trinler007/HA-Compass/dashboard/README.md

# Dashboard (Ziel 2)

## Fahrzeuggrafik

| Datei | Verwendung |
| --- | --- |
| `assets/nx01-top.svg` | Vektor-Draufsicht, Front oben, Maßstab 1 px = 10 mm, Drehpunkt (122.5, 349.5) – für Lovelace (Smartphone, Tablet, PC) |
| `assets/nx01-top-{120,180,240,360}.png` | transparente PNG-Exporte in fester Höhe – für openHASP (`img`-Objekt, Drehung über `angle`) |
| `assets/nx01-side.svg` | Seitenansicht (Fahrerseite, Front links), 1 Einheit = 10 mm, Bodenlinie unten – für Nicken |
| `assets/nx01-rear.svg` | Heckansicht, 1 Einheit = 10 mm, Bodenlinie unten – für Rollen |
| `assets/nx01-side-{400,800}.png`, `assets/nx01-rear-{240,480}.png` | transparente PNG-Exporte (z. B. für die Ultra Vehicle Card) |
| `../openhasp/nx01-side-289x150.png`, `../openhasp/nx01-rear-129x150.png` | passend für die Bildfelder der Nivellierseite (Seite 2) |

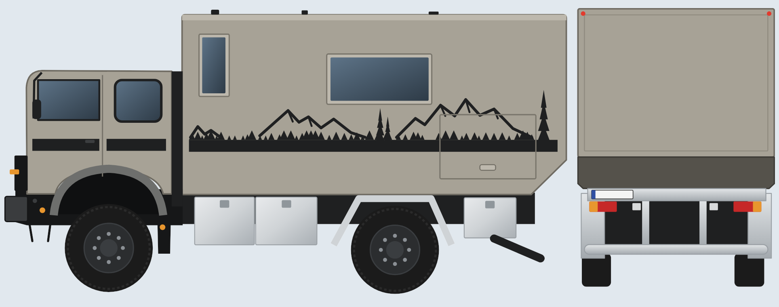
[picture p1: dashboard/ansichten-vorschau.png]
Seiten- und Heckansicht


Kennzeichen, Firmenlogos und Motive Dritter sind bewusst nicht enthalten; das Dekor ist vereinfacht nachgezeichnet.

Nachgezeichnet nach Drohnenaufnahmen (Tunesien), der Dachkamera und den Fahrzeugmaßen (6990 × 2450 mm):

- Fahrerhaus mit mittiger Dachprofilierung (Sicken)
- Wohnkoffer mit 6 Solarmodulen (2 × 3) und Dachfenster
- rechts in einer Flucht, von vorn nach hinten: 5G-Antenne (weiß), WiFi-Antenne (weiß), Kathrein HDZ 100 Kabel-Dachdurchführung
- Heck rechts: LoRa-Magnetfußantenne auf weißem Blech 35 × 35 cm, links daneben Starlink Mini

## Konzept

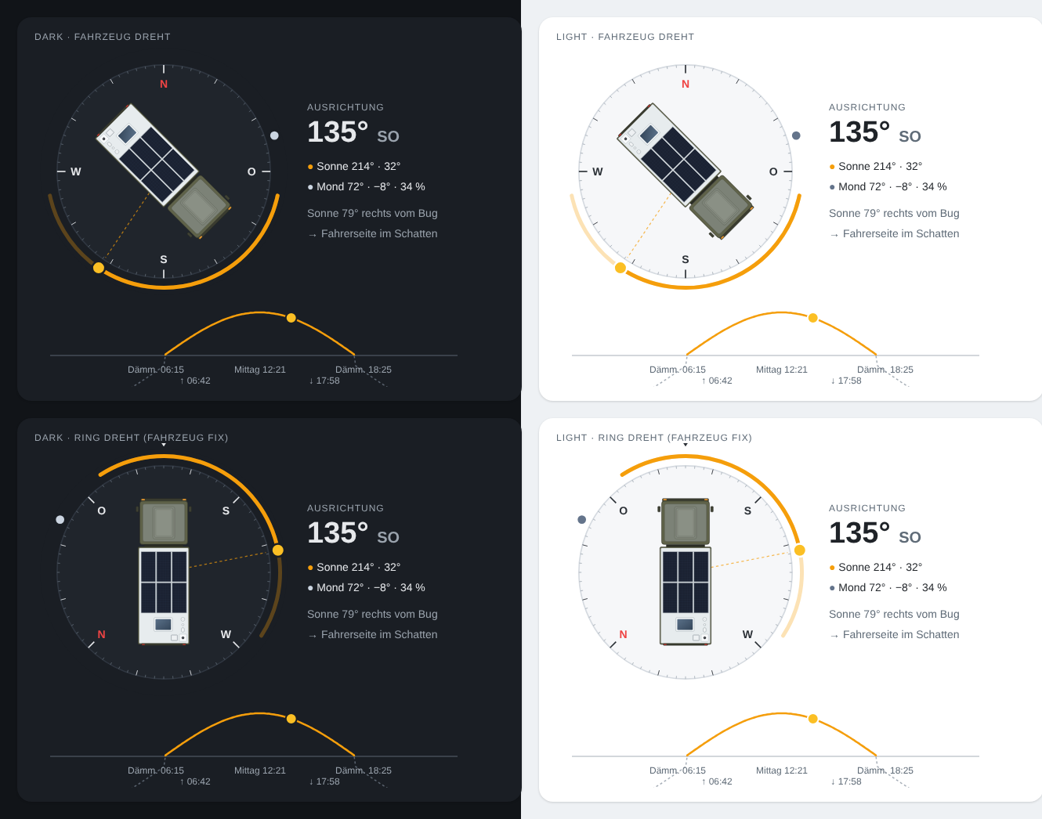
[picture p2: dashboard/konzept.png]
Konzept


- Kompassring mit Himmelsrichtungen; konfigurierbar: **Fahrzeug dreht** (Nord oben) oder **Ring dreht** (Fahrzeug fix, Fahrtrichtung oben)
- helles und dunkles Design (folgt dem HA-Theme)
- Horizontstreifen mit Sonnenhöhe über den Tag, Dämmerung, Auf-/Untergang, Mittag (ersetzt die Horizon Card)
- Sonnenbahn des Tages (Aufgang → Untergang) mit aktueller Sonnenposition
- Mondposition und -phase
- Text: Ausrichtung, Sonnen-/Mondstand, Sonne relativ zum Fahrzeug („Fahrerseite im Schatten“)

Die Mockup-Werte sind Beispielwerte.

## Architektur

```
HA-Compass (HACS-Integration, Domain ha_compass)
├── Sensoren für die aktuelle GPS-Position (nicht die HA-Heimatposition):
│   Sonne: Azimut, Höhe, Dämmerung, Aufgang, Mittag, Untergang
│   Mond:  Azimut, Höhe, Phase, Beleuchtung, Auf-/Untergang
│   relativ zum Fahrzeug: Sonnenwinkel zum Bug, beschattete Seite
├── Lovelace-Karte ha-compass-card (wird von der Integration mitgeliefert und registriert)
└── openHASP-Seite 480 × 480 (Vorlage)
```

Eine eigene Integration ist nötig, weil die HA-Integrationen `sun` und `moon` mit der festen Heimatposition rechnen
und keine Mondposition liefern. Im Wohnmobil muss mit der GPS-Position gerechnet werden.

## Lovelace-Karte `ha-compass-card`

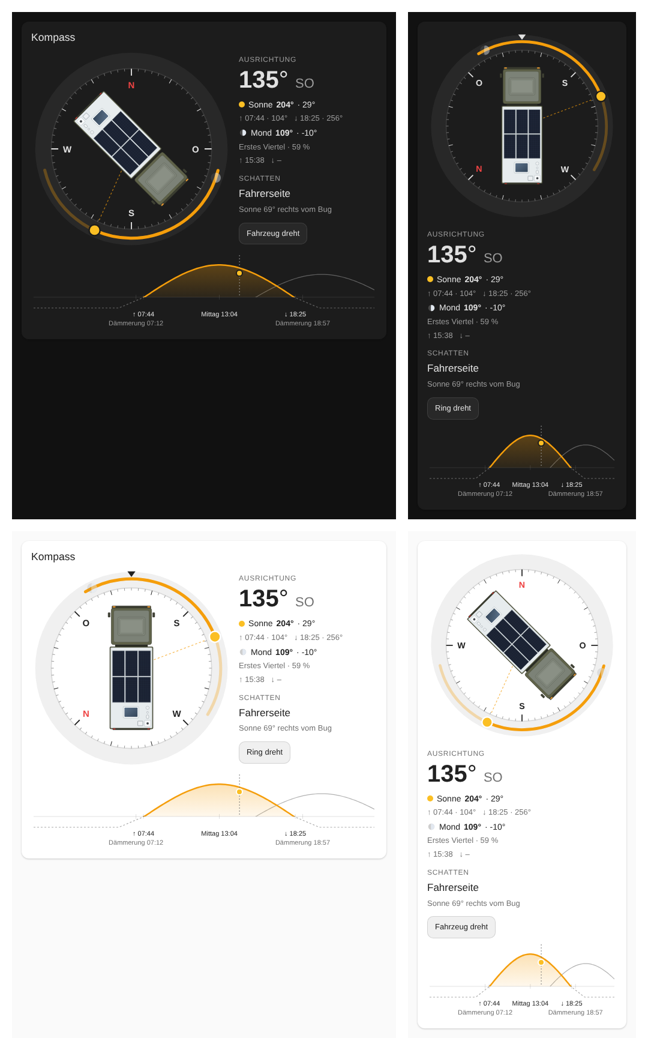
[picture p3: dashboard/karte-vorschau.png]
Vorschau


Die Karte wird von der Integration mitgeliefert und beim Start automatisch als Dashboard-Ressource (`/ha_compass/ha-compass-card.js`, JavaScript-Modul) eingetragen – keine separate HACS-Installation. Bei Dashboards im YAML-Modus die Ressource von Hand eintragen. Nach Updates einmal die Seite ohne Cache neu laden.
Sie folgt dem HA-Theme (hell/dunkel) und ordnet sich ab ca. 520 px Kartenbreite nebeneinander an, darunter untereinander.

```yaml
type: custom:ha-compass-card
heading_entity: sensor.kompass_ausrichtung_geografisch
title: Kompass
```

Alle Elemente lassen sich einzeln ein- und ausblenden (Standard: alles an) – im visuellen Editor in den Abschnitten *Kompass*, *Infospalte* und *Horizontverlauf*:

| Option | Standard | Wirkung |
| --- | --- | --- |
| `view` | `auto` | `auto` = folgt `select.ha_compass_ansicht`, `vehicle` = Fahrzeug dreht, `ring` = Ring dreht |
| `show_compass` | `true` | Kompass komplett |
| `show_vehicle`, `show_ticks`, `show_cardinals` | `true` | Fahrzeug, Skala, Himmelsrichtungen |
| `show_sun`, `show_sun_path`, `show_moon` | `true` | Sonne mit Richtungsstrahl, Sonnenbahn, Mond |
| `show_bow_marker` | `true` | Markierung „vorne“ im Modus *Ring dreht* |
| `tap_action` | `toggle_view` | `toggle_view` oder `none` |
| `compass_size` | – | maximale Kompassgröße in px |
| `vehicle_image` | – | eigenes Fahrzeugbild (URL, Front oben) |
| `show_info` | `true` | Infospalte komplett |
| `show_heading`, `show_sun_info`, `show_moon_info`, `show_shade`, `show_view_button` | `true` | einzelne Blöcke der Infospalte |
| `show_mobile_panel` | `true` | Solartaschen stilisiert in der Kompassrose: empfohlene Richtung (orange Kante = Sonnenseite), Breite nach Neigung |
| `show_solar`, `show_mobile` | `true` | Solarspalte rechts: Dach (tagsüber Ist/erwartet/Performance, nachts Prognose morgen) und Solartaschen-Empfehlung; erscheint nur mit den Solar-Sensoren der Integration |
| `show_horizon`, `show_moon_path` | `true` | Horizontverlauf, Mondkurve darin |

Beispiel – nur der Ring für eine Unterseite:

```yaml
type: custom:ha-compass-card
heading_entity: sensor.kompass_ausrichtung_geografisch
show_info: false
show_horizon: false
```

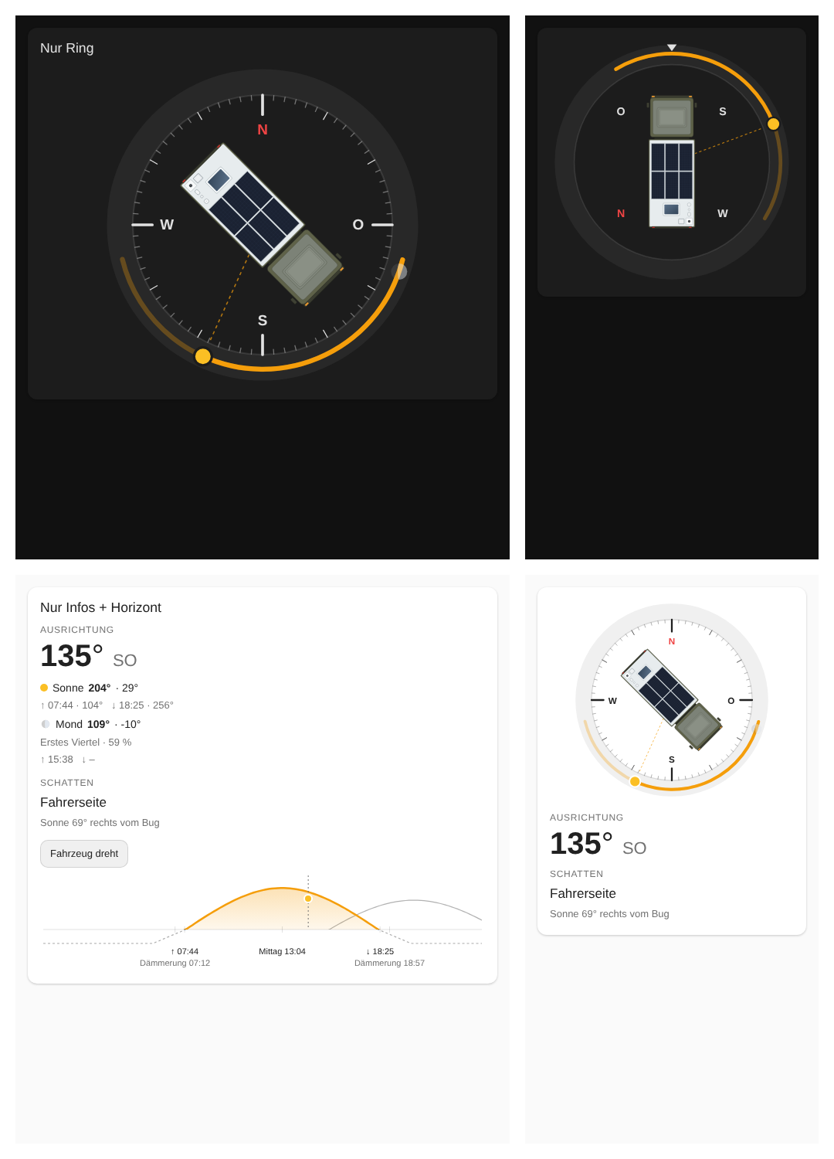
[picture p4: dashboard/karte-varianten.png]
Varianten


Tippen auf den Kompass oder den Button schaltet die Ansicht um (bei `view: auto` für alle Anzeigen inkl. openHASP).
Die Karte ist auch im visuellen Editor konfigurierbar.

## Nivellier-Karte `ha-level-card`

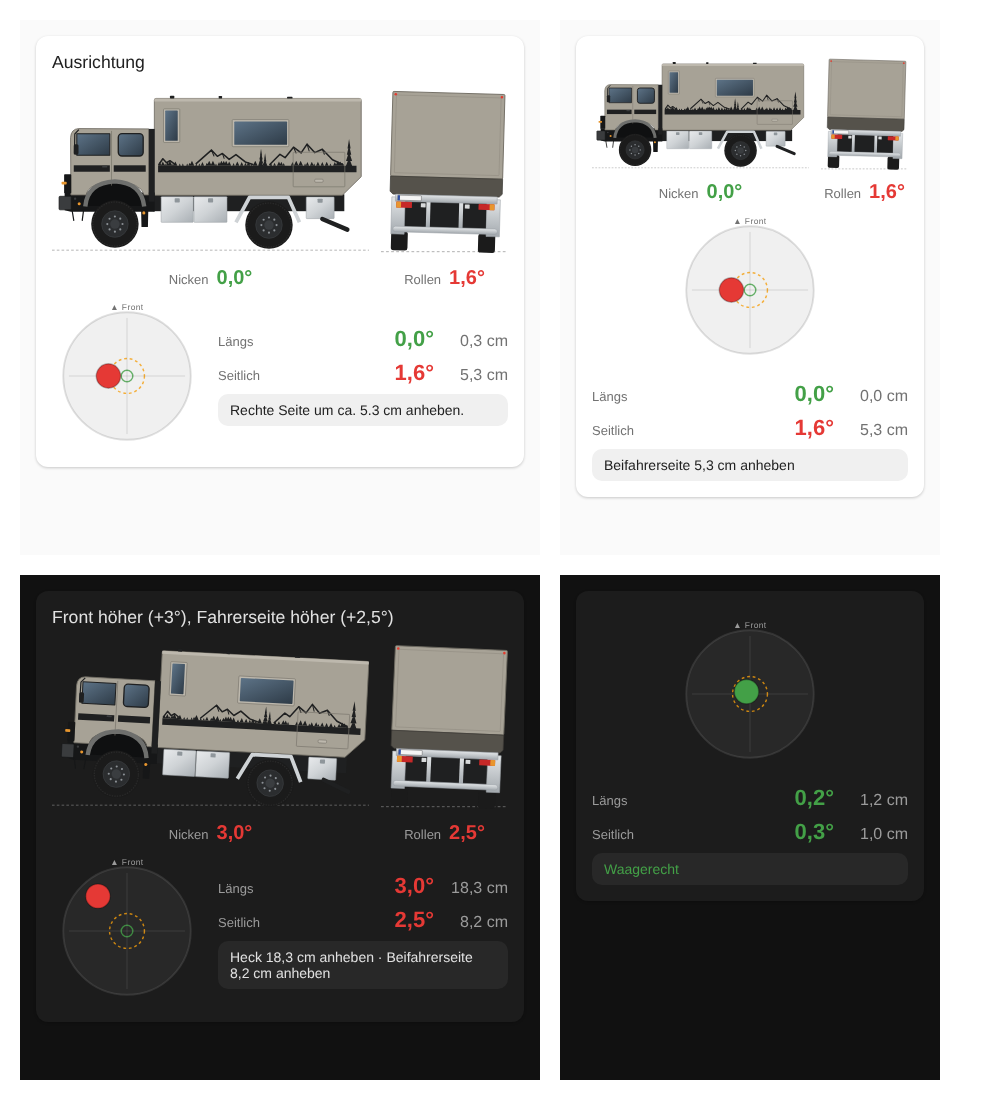
[picture p5: dashboard/nivellierung-vorschau.png]
Nivellierung


Ersetzt van-tilt-card, realistic-bubble-level-card und die Werteliste in einer Karte: Seitenansicht (Nicken) und Heckansicht (Rollen) drehen mit,
Libelle mit Toleranz- und Warnring, Werte farbig (grün ≤ Toleranz, gelb ≤ Warnschwelle, rot darüber), Höhendifferenzen in cm und Hinweis.

```yaml
type: custom:ha-level-card
pitch_entity: sensor.technik_wasserwaage_truck_pitch   # + = Front höher
roll_entity: sensor.technik_wasserwaage_truck_roll     # + = Fahrerseite höher
title: Ausrichtung
# optional – sonst aus Radstand/Spurweite berechnet:
height_long_entity: sensor.technik_wasserwaage_hohendifferenz_langs
height_side_entity: sensor.technik_wasserwaage_hohendifferenz_seitlich
hint_entity: sensor.technik_wasserwaage_nivellier_hinweis
```

| Option | Standard | Wirkung |
| --- | --- | --- |
| `show_views`, `show_bubble`, `show_values`, `show_hint` | `true` | Ansichten, Libelle, Werte, Hinweis |
| `wheelbase` / `track_width` | `3500` / `1886` mm | Basis für die berechneten Höhendifferenzen |
| `tolerance` / `warn` | `0.5` / `1.5` ° | Farbgrenzen |
| `bubble_range` | `5` ° | Vollausschlag der Libelle |
| `invert_pitch` / `invert_roll` | `false` | Vorzeichen umkehren, falls der Sensor andersherum zählt |

Drehrichtung: Nicken + (Front höher) dreht die Seitenansicht im Uhrzeigersinn, Rollen + (Fahrerseite höher) dreht die Heckansicht im Uhrzeigersinn
(von hinten gesehen liegt die Fahrerseite links). Die Libellenblase wandert immer zur höheren Seite.

Sobald der SCL3300 verbaut ist, liefert der Kompass-ESP Nicken und Rollen selbst – dann nur die Entitäten umstellen.
