trinler007/HA-Compass/docs/inbetriebnahme.md

# Inbetriebnahme

Reihenfolge einhalten – jeder Schritt baut auf dem vorherigen auf.

## 1. Werkbanktests

Ziel: Hardware, Einheiten und Datenfluss prüfen, bevor etwas fest eingebaut ist.
Für diese Tests die Diagnose-Entitäten **Magnetfeld X/Y/Z roh** in HA aktivieren (standardmäßig deaktiviert).

| Test | Erwartung |
| --- | --- |
| I²C-Scan im Log | Gerät an `0x30` gefunden |
| Einheit | Gesamtfeld √(x²+y²+z²) ≈ 48 (µT). Liegt der Wert bei ≈ 0,48, liefert der Sensor Gauss – dann Schwellwerte in der YAML anpassen. |
| Rauschen | Sensor ruhig liegen lassen: Rohwerte schwanken um weniger als ±0,5 µT |
| Störungen am Tisch | ESP-Last (z. B. OTA-Update) und USB-Netzteil ein/aus: Rohwerte ändern sich nicht sprunghaft |
| X-Achse | Platine flach, X-Pfeil nach Norden (Handykompass): X roh ist maximal |
| HA-Werte im ESP | Im Log keine Warnungen zu den `homeassistant`-Sensoren; Neigungskompensation liefert plausible Werte |
| Buttons | „Kalibrierung starten“ → Binärsensor „Kalibrierung läuft“ an; „beenden“ ohne Drehung → Log meldet *Kalibrierung verworfen*, alte Werte bleiben aktiv |
| Mini-Kalibrierung | Start drücken, Platine flach mehrmals um 360° drehen, Stopp: Log meldet *Kalibrierung OK*, Ausrichtung folgt dem Handykompass grob (ohne Fahrzeug-Offsets) |

Die Achsen-Vorzeichen werden **nicht** am Tisch festgelegt, sondern in Einbaulage (Schritt 2).

## 2. Einbau und Achsen-Vorzeichen

Einbau nach [hardware.md](hardware.md#montage-im-fahrzeug). Danach in Einbaulage:

**`z_sign`** – Das Erdfeld zeigt bei uns steil nach unten.
Ist *Magnetfeld Z roh* deutlich **positiv** → `z_sign: "1.0"`, sonst `"-1.0"`.

**`y_sign`** – Im internen System zeigt Y nach rechts. Steht das Fahrzeug Richtung Osten, liegt Nord links, Y muss also negativ sein.
Praktisch: Y roh in zwei Fahrzeugrichtungen vergleichen (z. B. Nord und Ost). Wird Y beim Drehen im Uhrzeigersinn (Nord → Ost) **kleiner** → `y_sign: "1.0"`, sonst `"-1.0"`.

Wegen der Kopfüber-Montage landen voraussichtlich beide Werte bei `-1.0`.
Eintragen unter `substitutions:` in der Gerätedatei, dann neu flashen.

## 3. Störtest am Einbauort

Sensor **Horizontalfeld** beobachten und jeweils ca. 1 Minute schalten:
Router an/aus · Schranktür auf/zu · Multiplus unter Last (z. B. Wasserkocher) · Funkgerät sendet.
Ziel: Ausrichtung schwankt um weniger als ±1°.

## 4. Z-Offset

Mit dem Neigungssensor SCL3300 **entfällt dieser Schritt**: Die Kreisfahrt bestimmt den Z-Offset mit
und rechnet die Gehäuseneigung aus den X/Y-Offsets heraus (sonst bis zu ~6° richtungsabhängiger Fehler
bei 2–3° Schräglage). `vertical_field_ut` (Standard 43,5 µT) ist die Vertikalkomponente des Erdfelds –
genauer Wert über den NOAA Magnetic Field Calculator.

Nur mit der Wasserwaage aus HA: zu Hause auf ebenem Grund (Nicken und Rollen jeweils < 1,5°)
Button **Kompass Z-Offset ermitteln** (Messung 10 s, Ergebnis im Log).

## 5. Kreisfahrt-Kalibrierung

Auf einer möglichst ebenen, freien Fläche:
1. Im Stand **Kompass Kalibrierung starten** und 3 s stehen bleiben (Gehäuselage wird gemessen, Log: *Kalibrierung gestartet*)
2. Langsam **etwas mehr als einen vollen Kreis** fahren (Wendekreis 15,6 m → ca. 50 m Strecke)
3. **Kompass Kalibrierung beenden** (Sicherheits-Timeout: 3 min)

Der ESP prüft die Messung (beide Radien > 10 µT, Verhältnis 0,7–1,4) und verwirft unvollständige Kreise automatisch.
Im Log: `Kalibrierung OK: Offset X/Y/Z …, Radius X/Y …, Gehäuselage …`. Beide Radien sollten nahe am
Horizontalfeld liegen (Allgäu ≈ 20–21 µT) und sich um weniger als ~10 % unterscheiden.
Danach setzt sich der GPS-Abgleich automatisch zurück.

## 6. Erste Fahrt – GPS-Abgleich

Voraussetzung: NMEA-Stream des RUTX50 aktiv.
Bei Geradeausfahrt ab 30 km/h, HDOP < 2 und ruhigem Kurs sammelt der ESP Messpunkte (Sensor **GPS-Abgleich Messpunkte**).
**Kompass Korrektur** pendelt sich bei *Missweisung (ca. +4° im Allgäu) + Einbauwinkel* ein und wandert auf Reisen automatisch mit.

Kontrolle: Nach der Fahrt auf gerader Straße anhalten und **Ausrichtung geografisch** mit dem letzten GPS-Kurs vergleichen.
Größere Abweichungen im Stand deuten auf Störungen, die nur während der Fahrt auftreten (z. B. B2B-Lader).

## Neigungssensor SCL3300

Die Neigungsquelle wird in der Gerätedatei `esphome/kompass.yaml` unter `packages: … files:` gewählt:
`esphome/packages/neigung-scl3300.yaml` (SCL3300 im Gehäuse) oder `esphome/packages/neigung-homeassistant.yaml` (vorhandene Wasserwaage in HA) – immer genau eines.
Solange der SCL3300 nicht aufgesteckt ist, das HA-Paket verwenden; sonst meldet die Komponente beim Start einen Fehler.
Die Komponente `scl3300` wird beim Kompilieren automatisch aus diesem Repository geladen (`external_components`).

1. **Aufstecken und flashen.** Im Log muss beim Start stehen: `SCL3300 erkannt (WHOAMI 0xC1), Modus 1`.
   `Kennung 0x.. statt 0xC1` oder `Keine gültige Antwort (CRC)` → Verdrahtung prüfen (Farbtabelle in `hardware.md`).
2. **Achsen bestimmen.** Diagnose-Entitäten *Neigungssensor X/Y/Z roh* aktivieren.
   - **oben:** Die Achse, die in Einbaulage ≈ ±1 g zeigt. +1 g → `scl_up: "+…"`, −1 g → `"-…"`.
   - **vorne:** Gehäuse vor dem Festschrauben an der FRONT-Seite leicht anheben. Die Achse, deren Wert dabei steigt → `"+…"`, fällt → `"-…"`.
   - **links:** Fahrerseite leicht anheben. Die Achse, deren Wert dabei steigt → `"+…"`, fällt → `"-…"`.
     Nicht aus der Rechte-Hand-Regel ableiten – beim SCL3300 der NX-01 ergab der Test `+x / +y / -z`.
   - Eintragen unter `substitutions:` in der Gerätedatei (überschreibt die Standardwerte des Pakets).
   - Kontrolle: Im Log warnt `Achse 'up' misst … g`, wenn „oben“ falsch ist.
3. **Plausibilität:** *Neigung längs* wird positiv, wenn die Front höher steht; *Neigung seitlich* positiv, wenn die Fahrerseite höher steht.
4. **Nullpunkt** – drei Wege, das Ergebnis bleibt nach Neustarts erhalten:
   - **Mit Referenz (empfohlen):** Fahrzeug beliebig abstellen, die tatsächliche Neigung (Wasserwaage auf dem Boden,
     alte Wasserwaage in HA) in **Neigung Referenz längs/seitlich** eintragen (+ = Front bzw. Fahrerseite höher),
     dann **Neigung Nullpunkt setzen** (Messung über 5 s).
   - **Eben:** Referenz auf 0/0 lassen und auf ebenem Grund **Neigung Nullpunkt setzen**.
   - **Direkt:** **Neigung Nullpunkt längs/seitlich** von Hand eintragen oder nachkorrigieren
     (= Gehäuselage bei waagerechtem Fahrzeug; angezeigte Neigung = Gehäuselage − Nullpunkt).
   Der Nullpunkt wirkt nur auf die Nivellierwerte – die Kompass-Neigungskompensation nutzt immer die Gehäuselage.
5. Danach Z-Offset und Kreisfahrt-Kalibrierung des Kompasses (die SCL-Platine liegt nahe am Magnetometer).

Neue Entitäten: *Neigung längs*, *Neigung seitlich*, *Höhendifferenz längs/seitlich* (cm, aus Radstand/Spurweite),
*Nivellier-Hinweis*, *Neigungssensor Temperatur*. In `ha-level-card` und auf der openHASP-Seite 2 die bisherigen
Wasserwaagen-Entitäten durch diese ersetzen.

## Fehlersuche

| Symptom | Ursache / Abhilfe |
| --- | --- |
| Ausrichtung um ~180° falsch | X-Pfeil zeigt nach hinten – Sensor um 180° drehen oder `x_sign` und `y_sign` auf `"-1.0"` |
| Ost und West vertauscht | `y_sign` falsch |
| Fehler wächst mit Schräglage | `z_sign`, Z-Offset oder Gehäuse nicht parallel zur Wasserwaage |
| Ausrichtung springt bei Verbrauchern | Störquelle in Sensornähe – Horizontalfeld prüfen |
| GPS-Messpunkte steigen nicht | NMEA-Status, Geschwindigkeit, HDOP prüfen; Schalter „GPS-Abgleich“ an? |
| Kalibrierung verworfen | Kreis unvollständig oder Fahrt zu schnell – wiederholen |
| SCL3300: falsche Kennung / CRC-Fehler | Verdrahtung, 3V3 an AVDD **und** DVIO, Masse an AVSS **und** DVSS |
| Neigung längs/seitlich mit falschem Vorzeichen | `scl_forward` bzw. `scl_left` umkehren |

## Bedienelemente in HA

| Entität | Typ | Zweck |
| --- | --- | --- |
| Ausrichtung magnetisch / geografisch | Sensor | Ergebnis (°) |
| Kompass Kalibrierung starten / beenden | Button | Kreisfahrt |
| Kompass Kalibrierung läuft | Binärsensor | Status |
| Kompass Z-Offset ermitteln | Button (Konfiguration) | einmalig auf ebenem Grund |
| GPS-Abgleich zurücksetzen | Button (Konfiguration) | Korrektur auf Startwert |
| Neigungskompensation, GPS-Abgleich | Schalter (Konfiguration) | Funktionen ein/aus |
| Kompass Korrektur, GPS-Abgleich Messpunkte, Horizontalfeld | Diagnose | Überwachung |
