trinler007/HA-Compass/dashboard/assets/nx01-rear-240.png

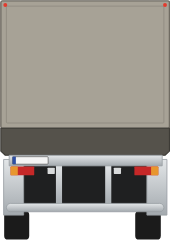
dashboard/assets/nx01-rear-240.png
