trinler007/HA-Compass/dashboard/assets/nx01-side-400.png

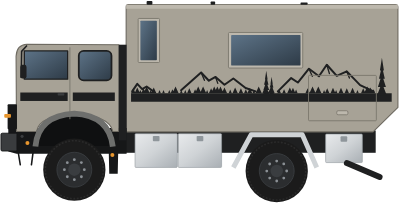
dashboard/assets/nx01-side-400.png
