trinler007/HA-Compass/dashboard/assets/nx01-top-360.png

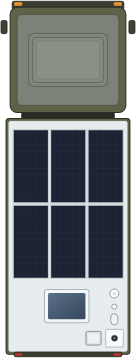
dashboard/assets/nx01-top-360.png
