trinler007/HA-Compass/openhasp/nx01-rear-129x150.png

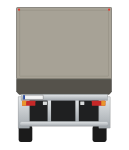
openhasp/nx01-rear-129x150.png
