trinler007/HA-Compass/openhasp/nx01-side-289x150.png

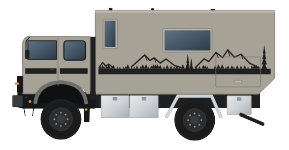
openhasp/nx01-side-289x150.png
