trinler007/HA-Compass/openhasp/nx01.png

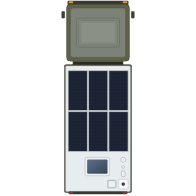
openhasp/nx01.png
