trinler007/HA-Compass/(commit log)

2026-10-18 Ziel 1: Kompass-Sensor mit ESPHome, Gehäuse und Dokumentation
    - ESPHome-Konfiguration für ESP32-S3 + MMC5603 mit Kreisfahrt-Kalibrierung,
    Z-Offset, Neigungskompensation (Wasserwaage aus HA) und automatischem
    GPS-Abgleich über den RUTX50 (HA-Teltonika, NMEA)
    - Parametrisches OpenSCAD-Gehäuse (Sensor quer, verschraubter Deckel)
    - Schaltplan, Hardware-Doku, Inbetriebnahme mit Werkbanktests, Funktionsweise
    Claude-Session: https://claude.ai/code/session_013DCenfRdCFAbqtyfTagYZP
    [camper-kompass-gehaeuse.scad]
2026-10-18 Gehäuse: Einbauvarianten längs und quer
    - Neuer Parameter einbau ("laengs" | "quer") steuert Platinenlage und Deckel
    - Zweiter Deckel mit Pfeil "FRONT" zur langen Seite für den Quereinbau
    - Doku: Varianten in hardware.md beschrieben
    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
    [camper-kompass-gehaeuse.scad]
2026-10-18 Wasserwaage: Pitch/Roll-Entitäten nach Umbenennung in HA zugeordnet
    Die Entitäten heißen jetzt konventionsgemäß:
    pitch = Nicken (+ Front höher), roll = Rollen (+ Fahrerseite höher).
    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
2026-10-19 Dashboard: Fahrzeug-Draufsicht (SVG/PNG) und Konzeptbild
    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
2026-10-19 Dashboard: Draufsicht korrigiert (Dachprofil, Antennen, Starlink, LoRa), Konzept mit beiden Drehmodi und Themes, Architektur
    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
2026-10-19 Integration HA Compass und openHASP-Kompassseite
    - custom_components/ha_compass: Sonne/Mond (SunCalc-Port) für die HA-Position,
    Sonnenwinkel zum Bug, Schattenseite, Ansichtsauswahl; Config-Flow, de/en
    - openhasp: Seite 9 (480 × 480) mit Bindungen für die openHASP-Integration,
    Generator, Vorschau, Fahrzeugbild
    - Draufsicht: Dachprofil des Fahrerhauses quer
    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
2026-10-19 Lizenz (Apache-2.0) und NOTICE mit SunCalc-Hinweis (BSD-2-Clause)
    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
2026-10-19 Lovelace-Karte ha-compass-card
    - Kompass mit Fahrzeug, Sonnenbahn, Sonne/Mond (Mondphase), beide Drehmodi
    - Infospalte und Horizontverlauf (Sonne/Mond über den Tag) als Ersatz für die Horizon Card
    - hell/dunkel über HA-Theme, responsiv, visueller Editor
    - wird von der Integration ausgeliefert und automatisch geladen (v0.2.0)
    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
2026-10-19 Gehäuse v3.3: Halterung für Neigungssensor SCL3300-D01-PCB, Verdrahtung dokumentiert
    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
    [camper-kompass-gehaeuse.scad]
2026-10-19 0.3.0: Icon/Logo für die Integration, Kartenelemente einzeln schaltbar
    - custom_components/ha_compass/brand: icon, logo, dark_logo (je 1x/2x)
    - Karte: Kompass-, Info- und Horizont-Elemente einzeln ein-/ausblendbar,
    tap_action, compass_size; Editor in aufklappbaren Abschnitten
    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
2026-10-19 Seiten- und Heckansicht als SVG + PNG-Exporte (inkl. openHASP-Formate)
    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
2026-10-19 0.4.1: Editor zeigt Standardwerte korrekt an (Schalter abschaltbar), Spurweite 1886 mm
    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
2026-10-19 openHASP: dunkler Hintergrundkreis hinter der Sonnenbahn; Vorschau-Skript
    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
2026-10-19 Doku: Aderfarben der SCL3300-Verkabelung, Status Einbau
    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
2026-10-30 ESPHome-Komponente scl3300 und Neigungs-Pakete
    - components/scl3300: SPI-Off-Frame-Protokoll mit CRC, Kennungsprüfung (0xC1),
    Fehlerzähler/Re-Init, Achszuordnung (rechtshändig geprüft), Nicken/Rollen,
    Rohbeschleunigung, Temperatur
    - packages/neigung-scl3300.yaml: Neigungskompensation, Nivellierwerte,
    Höhendifferenzen, Hinweis, Nullpunkt (persistent)
    - packages/neigung-homeassistant.yaml: bisherige Wasserwaage als Alternative
    - Doku: Inbetriebnahme SCL3300, Fehlersuche
    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
2026-10-30 ESPHome: Logik als Pakete von GitHub, schlanke Gerätedatei
    - esphome/packages/kompass-basis.yaml: Kompass-Logik (MMC5603, Kalibrierung,
    Z-Offset, GPS-Abgleich), GPS-Entitäten und I²C-Pins als substitutions
    - esphome/kompass.yaml: Gerätedatei für den ESPHome Builder, lädt
    kompass-basis + Neigungspaket per packages: direkt aus dem Repo
    - camper-kompass.yaml entfällt; README und Inbetriebnahme angepasst
    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
2026-11-01 Neigungskompensation: Kompass nutzt Gehäuselage ohne Nullpunkt
    Magnetometer und SCL3300 liegen im selben Gehäuse; der Nullpunkt beschreibt
    nur die Lage des Gehäuses zum Fahrzeug und gilt nur für die Nivellierwerte.
    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
2026-11-01 Neigung: Achsen ohne Händigkeitsprüfung, Nullpunkt editierbar und per Referenzwert
    - scl3300: Rechtshändigkeitsprüfung entfernt (Vorzeichen werden empirisch bestimmt)
    - number: Neigung Nullpunkt längs/seitlich (direkt editierbar)
    - number: Neigung Referenz längs/seitlich; Nullpunkt setzen = Gehäuselage − Referenz
    - Inbetriebnahme angepasst
    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
2026-11-01 SCL3300-Paket: Refresh der externen Komponente als Substitution
    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
2026-11-03 Kreisfahrt: Gehäuseneigung herausrechnen, Z-Offset mitbestimmen
    Bei geneigtem Gehäuse verschiebt die Vertikalkomponente des Erdfelds die
    Kreismitten (Bv · Lotrichtung). Die mittlere Gehäuselage aus dem SCL3300
    wird während der Fahrt gemittelt und herausgerechnet; der Z-Offset ergibt
    sich aus der Z-Spanne. Simuliert: 2,7°/-1° Lage, 185 µT Hard-Iron ->
    0,0° Restfehler (vorher bis 6,1°).
    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
2026-11-03 Neigung und Fliehkraft: Lage für Kreisfahrt im Stand, in Fahrt träge Kompensation
    - Kreisfahrt misst die Gehäuselage 3 s im Stand vor dem Start statt während
    der Fahrt (Querbeschleunigung im Wendekreis ≈ 0,1 g bei 10 km/h)
    - Neigungskompensation über 5 km/h mit ≈ 10 s Zeitkonstante
    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
2026-11-03 Karte 0.4.4: Sonnenmarker im Horizontverlauf exakt auf der Kurve, Nachtbereich flacher
    Die Höhe des Markers wurde relativ zur ganzen Box (Grafik + Beschriftung)
    statt zur 90 px hohen Grafik berechnet – tagsüber einige Pixel zu tief,
    nachts in der Beschriftung.
    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
2026-11-04 Integration 0.5.0: Solarschätzung Dach und Solartaschen
    - solar.py: Klarhimmel-Einstrahlung, Einfallswinkel aus Ausrichtung und
    Fahrzeuglage, Zelltemperatur, Bewölkung, beste feste Aufstellung
    - Optionen: Neigung, Wp und Istleistung Dach/Solartaschen, Außentemperatur,
    Wetter, Systemfaktor (Startwerte NX-01)
    - 9 neue Sensoren (Einfallswinkel, erwartet, Neigungsgewinn, Tagesertrag,
    Performance, Solartaschen möglich/Neigung/Ausrichtung/Ausnutzung)
    - Standard-Ausrichtung jetzt sensor.kompass_ausrichtung_geografisch
    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
2026-11-04 Integration 0.5.1: Prognose für morgen in der aktuellen Lage, stündliche Bewölkung
    - Neuer Sensor Solar Dach Ertrag morgen (klar) mit Attributen mit_bewoelkung, waagerecht
    - Neigungsgewinn bezieht sich auf den Rest des Tages, nach Sonnenuntergang auf morgen
    - Stündliche Bewölkungsprognose (weather.get_forecasts) für Rest heute, morgen und Solartaschen
    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
2026-11-04 Karte 0.6.0: Solarspalte neben der Ausrichtung
    Tagsüber Istleistung, Performance, erwartet (klar/Wolken), Rest heute und
    Lagegewinn; nach Sonnenuntergang Prognose für morgen. Darunter die
    Solartaschen-Empfehlung (Neigung, Richtung, relativ zum Bug, Ertrag).
    Bricht bei schmaler Karte unter die Infospalte um.
    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
2026-11-04 Karte 0.6.1: Solartaschen stilisiert in der Kompassrose
    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
